pawel2000pl/LedDriverIoT/doc/example_board/IoT_Led_v1.kicad_pcb

## KiCad design doc/example_board/IoT_Led_v1.kicad_pcb (2026-05-27)

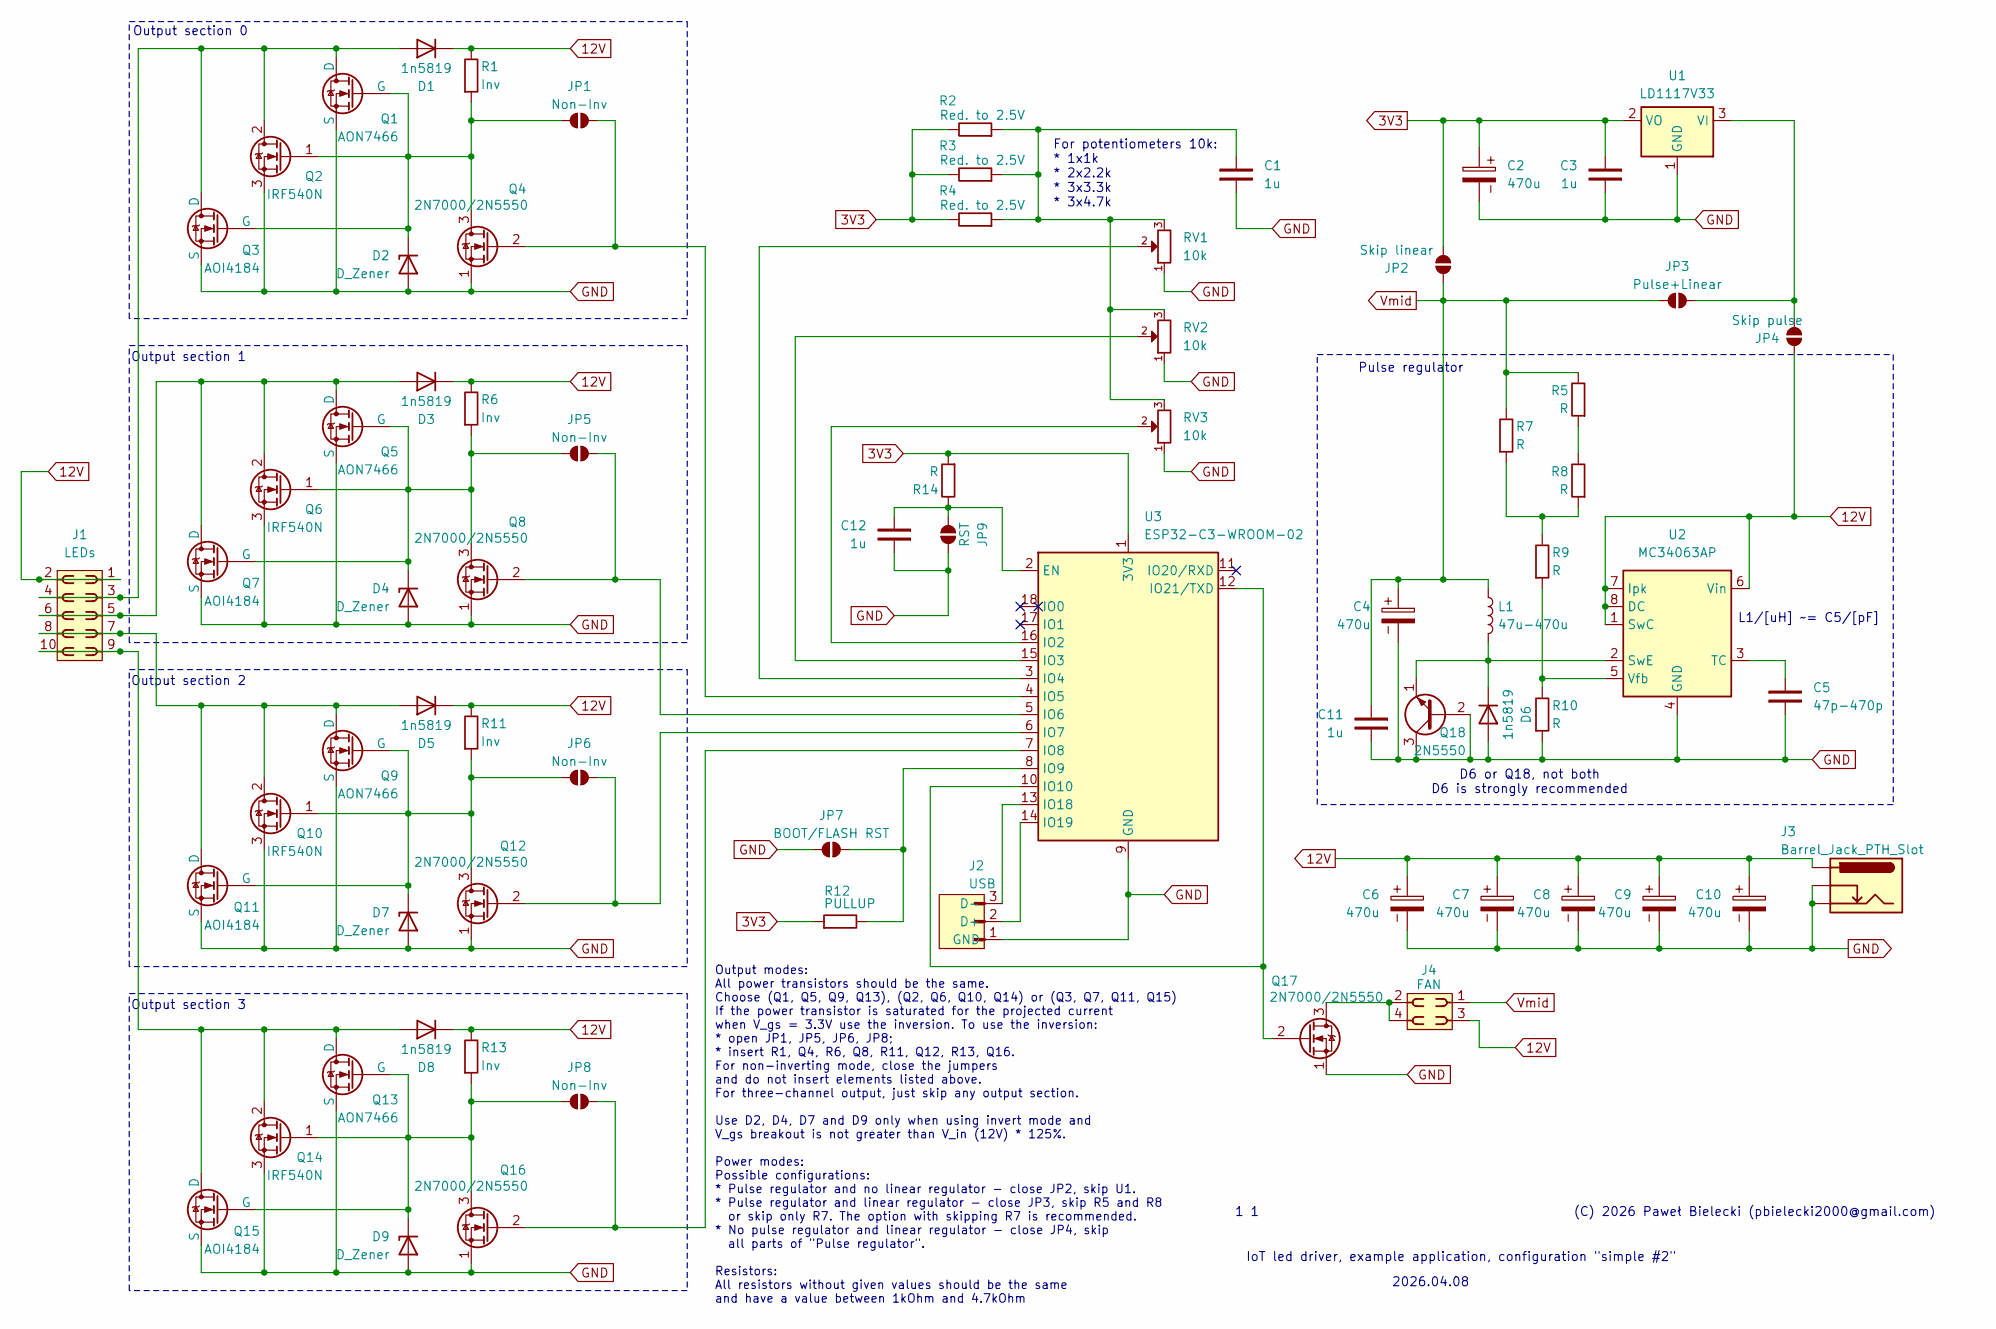
[picture p11: schematic IoT_Led_v1.kicad_sch]

Parts:
C1, C3, C11, C12: 1u; C_Disc_D3.0mm_W2.0mm_P2.50mm
C2, C4, C6, C7, C8, C9, C10: 470u; CP_Radial_D5.0mm_P2.50mm
C5: 47p-470p; C_Disc_D3.0mm_W2.0mm_P2.50mm
D1, D3, D5, D6, D8: 1n5819; D_DO-41_SOD81_P10.16mm_Horizontal
D2, D4, D7, D9: D_Zener; D_DO-41_SOD81_P10.16mm_Horizontal
J1: LEDs; PinSocket_2x05_P2.54mm_Vertical
J2: USB; PinHeader_1x03_P2.54mm_Vertical
J3: Barrel_Jack_PTH_Slot
J4: FAN; PinSocket_2x02_P2.54mm_Vertical
JP1, JP5, JP6, JP8: Non-Inv; Jumper_2_NO_NoSilk
JP2: Skip linear; Jumper_2_NO_NoSilk
JP3: Pulse+Linear; Jumper_2_NO_NoSilk
JP4: Skip pulse; Jumper_2_NO_NoSilk
JP7: BOOT/FLASH RST; Jumper_2_NO_NoSilk
JP9: RST; Jumper_2_NO_NoSilk
L1: 47u-470u; L_Axial_L5.3mm_D2.2mm_P2.54mm_Vertical_Vishay_IM-1
Q1, Q5, Q9, Q13: AON7466
Q2, Q6, Q10, Q14: IRF540N; TO-220-3_Vertical
Q3, Q7, Q11, Q15: AOI4184; TO-251-3_Vertical
Q4, Q8, Q12, Q16, Q17: 2N7000/2N5550; TO-92_Inline
Q18: 2N5550; TO-92_Inline
R1, R6, R11, R13: Inv; R_Axial_DIN0207_L6.3mm_D2.5mm_P10.16mm_Horizontal
R2, R3, R4: Red. to 2.5V; R_Axial_DIN0207_L6.3mm_D2.5mm_P10.16mm_Horizontal
R5, R7, R8, R9, R10, R14: R; R_Axial_DIN0207_L6.3mm_D2.5mm_P10.16mm_Horizontal
R12: PULLUP; R_Axial_DIN0207_L6.3mm_D2.5mm_P10.16mm_Horizontal
RV1, RV2, RV3: 10k; Potentiometer_Alps_RK163_Single_Horizontal
U1: LD1117V33; TO-220-3_Vertical
U2: MC34063AP; DIP-8_W7.62mm
U3: ESP32-C3-WROOM-02

Connections:
3V3: C2.1, C3.2, JP2.1 (A), R2.2, R3.2, R4.2, R12.1, R14.1, U1.2 (VO), U3.1 (3V3)
12V: C6.1, C7.1, C8.1, C9.1, C10.1, D1.1 (K), D3.1 (K), D5.1 (K), D8.1 (K), J1.1, J1.2, J3.PWR, J4.3, JP4.2 (B), R1.2, R6.2, R11.2, R13.2, U2.1 (SwC), U2.6 (Vin), U2.7 (Ipk), U2.8 (DC)
GND: C1.1, C2.2, C3.1, C4.2, C5.1, C6.2, C7.2, C8.2, C9.2, C10.2, C11.1, C12.1, D2.2 (A), D4.2 (A), D6.2 (A), D7.2 (A), D9.2 (A), J2.1 (GND), J3.GND, J3.GNDBREAK, JP7.1 (A), JP9.2 (B), Q1.3 (S), Q2.3 (S), Q3.3 (S), Q4.1 (S), Q5.3 (S), Q6.3 (S), Q7.3 (S), Q8.1 (S), Q9.3 (S), Q10.3 (S), Q11.3 (S), Q12.1 (S), Q13.3 (S), Q14.3 (S), Q15.3 (S), Q16.1 (S), Q17.1 (S), Q18.2 (B), Q18.3 (C), R10.1, RV1.1, RV2.1, RV3.1, U1.1 (GND), U2.4 (GND), U3.9 (GND), U3.19 (GND)
unnamed: C1.2, R2.1, R3.1, R4.1, RV1.3, RV2.3, RV3.3
unnamed: D1.2 (A), J1.3, J1.4, Q1.1 (D), Q2.2 (D), Q3.2 (D)
unnamed: D2.1 (K), JP1.2 (B), Q1.2 (G), Q2.1 (G), Q3.1 (G), Q4.3 (D), R1.1
unnamed: D3.2 (A), J1.5, J1.6, Q5.1 (D), Q6.2 (D), Q7.2 (D)
unnamed: D4.1 (K), JP5.2 (B), Q5.2 (G), Q6.1 (G), Q7.1 (G), Q8.3 (D), R6.1
unnamed: D5.2 (A), J1.7, J1.8, Q9.1 (D), Q10.2 (D), Q11.2 (D)
unnamed: D6.1 (K), L1.2, Q18.1 (E), U2.2 (SwE)
unnamed: D7.1 (K), JP6.2 (B), Q9.2 (G), Q10.1 (G), Q11.1 (G), Q12.3 (D), R11.1
unnamed: D8.2 (A), J1.9, J1.10, Q13.1 (D), Q14.2 (D), Q15.2 (D)
unnamed: D9.1 (K), JP8.2 (B), Q13.2 (G), Q14.1 (G), Q15.1 (G), Q16.3 (D), R13.1
unnamed: J2.2 (D+), U3.14 (IO19)
unnamed: J2.3 (D-), U3.13 (IO18)
unnamed: JP1.1 (A), Q4.2 (G), U3.4 (IO5)
unnamed: JP3.1 (A), JP4.1 (A), U1.3 (VI)
unnamed: JP5.1 (A), Q8.2 (G), U3.5 (IO6)
unnamed: JP6.1 (A), Q12.2 (G), U3.6 (IO7)
unnamed: JP7.2 (B), R12.2, U3.8 (IO9)
unnamed: JP8.1 (A), Q16.2 (G), U3.7 (IO8)
unnamed: C12.2, JP9.1 (A), R14.2, U3.2 (EN)
unnamed: J4.2, J4.4, Q17.3 (D)
unnamed: Q17.2 (G), U3.10 (IO10), U3.12 (IO21/TXD)
unnamed: R5.1, R8.2
unnamed: R7.1, R8.1, R9.2
unnamed: C5.2, U2.3 (TC)
unnamed: R9.1, R10.2, U2.5 (Vfb)
unnamed: RV3.2, U3.16 (IO2)
unnamed: RV2.2, U3.15 (IO3)
unnamed: RV1.2, U3.3 (IO4)
Vmid: C4.1, C11.2, J4.1, JP2.2 (B), JP3.2 (B), L1.1, R5.2, R7.2

Notes on the sheet:
L1/[uH] ~= C5/[pF]
2026.04.08
IoT led driver, example application, configuration "simple #2"
Output section 0
Pulse regulator
Output section 3
1 1
(C) 2026 Paweł Bielecki (pbielecki2000@gmail.com)
Output modes: All power transistors should be the same. Choose (Q1, Q5, Q9, Q13), (Q2, Q6, Q10, Q14) or (Q3, Q7, Q11, Q15) If the power transistor is saturated for the projected current when V_gs = 3.3V use the inversion. To use the inversion: * open JP1, JP5, JP6, JP8; * insert R1, Q4, R6, Q8, R11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
D6 or Q18, not both D6 is strongly recommended
For potentiometers 10k: * 1x1k * 2x2.2k * 3x3.3k * 3x4.7k
Output section 1
Output section 2

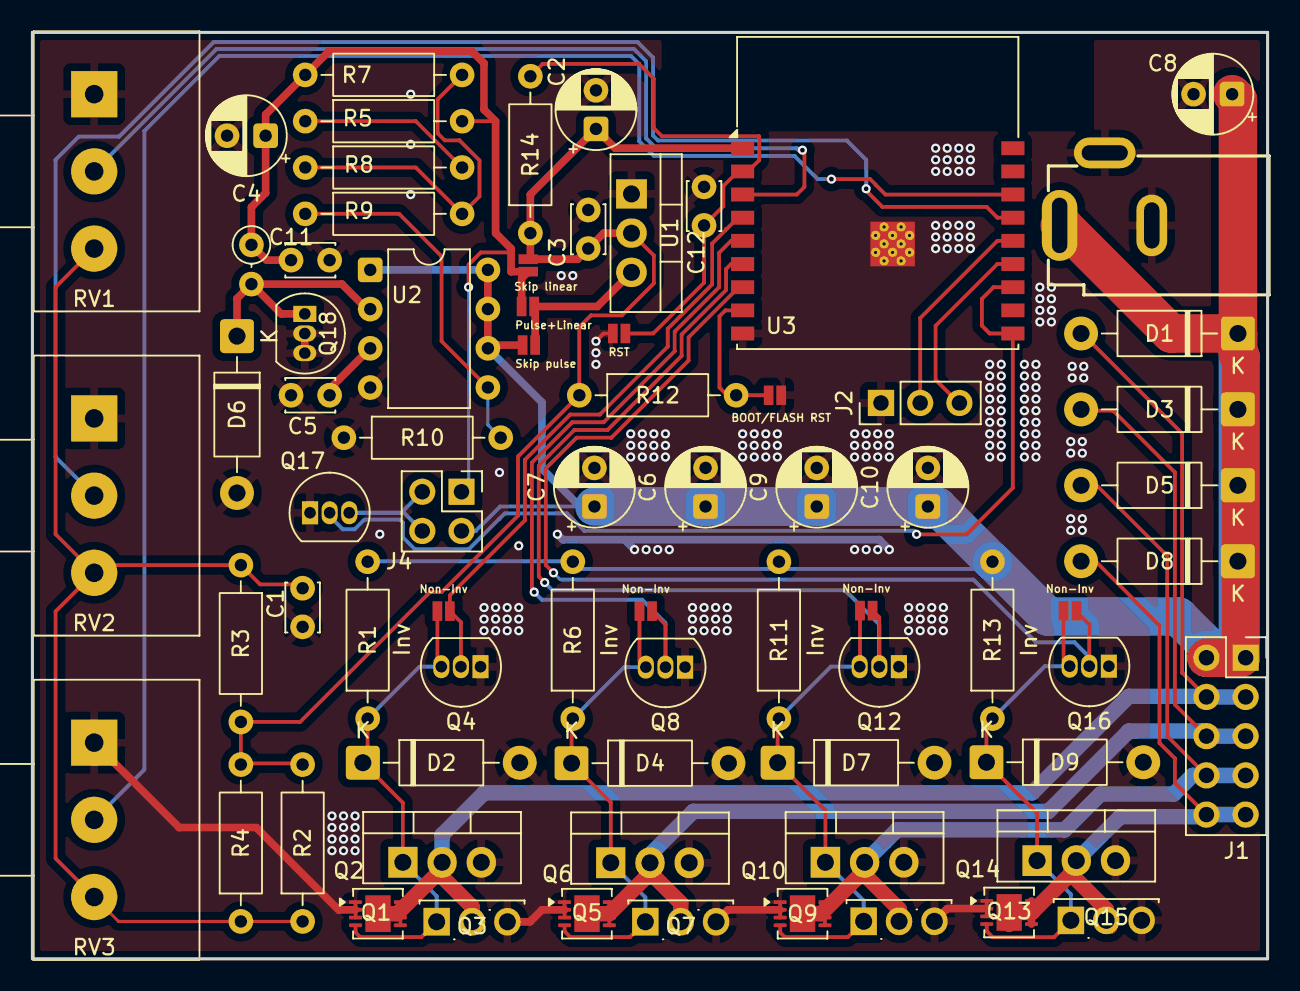
[picture p12: board IoT_Led_v1.kicad_pcb from above]

Board: 2 copper layers, 80.0 x 60.0 mm, 73 parts (0 on the bottom side), 32 nets.
