pawel2000pl/LedDriverIoT/main/src/hardware_configuration.cpp

#include "hardware_configuration.h"
#include "logs.h"
#include <cstdint>
#include <utility>

namespace hardware {


	void pullUpDelay() {
		delayMicroseconds(RELAXATION_PULL_DELAY);
	}


	void relaxationDelay() {
		auto wakeup = micros() + RELAXATION_DELAY;
		do vTaskDelay(5); while (micros() < wakeup);
	}


	std::pair<unsigned, unsigned> checkPin(int pin) {
		bool analogPin = pin >= 2 && pin <= 4;
		pinMode(pin, INPUT_PULLDOWN);
		pullUpDelay();
		unsigned v1 = analogPin ? analogRead(pin) : (ANALOG_READ_MAX * digitalRead(pin));
		pinMode(pin, INPUT_PULLUP);
		pullUpDelay();
		unsigned v2 = analogPin ? analogRead(pin) : (ANALOG_READ_MAX * digitalRead(pin));
		return {v1, v2};
	}


	// it just checks if a pin is not h/z
	bool analogHasPotentiometer(int pin) {
		auto v = checkPin(pin);
		return (v.first > ANALOG_READ_MAX * 0.1f) || (v.second < ANALOG_READ_MAX * 0.9f);
	}


	bool hasHz(int pin) {
		auto v = checkPin(pin);
		return (v.first < ANALOG_READ_MAX * 0.1f) && (v.second > ANALOG_READ_MAX * 0.9f);
	}


	bool hasLow(int pin) {
		auto v = checkPin(pin);
		return (v.first < ANALOG_READ_MAX * 0.1f) && (v.second < ANALOG_READ_MAX * 0.1f);
	}


	bool hasHigh(int pin) {
		auto v = checkPin(pin);
		return (v.first > ANALOG_READ_MAX * 0.9f) && (v.second > ANALOG_READ_MAX * 0.9f);
	}


	bool pinsAreConnected(int a, int b) {
		if (a == b) return true;

		pinMode(a, INPUT_PULLUP);
		pinMode(b, INPUT_PULLUP);
		pullUpDelay();
		bool v1a = digitalRead(a);
		bool v1b = digitalRead(b);

		pinMode(a, INPUT_PULLDOWN);
		pinMode(b, INPUT_PULLDOWN);
		pullUpDelay();
		bool v2a = !digitalRead(a);
		bool v2b = !digitalRead(b);

		bool result = false;

		if (v1a && v2a) { // if pin a has HZ
			pinMode(a, OUTPUT);
			digitalWrite(a, HIGH);
			pullUpDelay();
			result = digitalRead(b);
		} else if (v1b && v2b) { // if pin b has HZ
			pinMode(b, OUTPUT);
			digitalWrite(b, HIGH);
			pullUpDelay();
			result = digitalRead(a);
		} else {
			result = v1a == v1b && v2a == v2b && v1a == v2a;
		}

		pinMode(a, INPUT);
		pinMode(b, INPUT);

		return result;
	}


	fixed64 avgAnalog(int pin, unsigned count) {
		std::uint64_t sum = 0;
		for (unsigned i=0;i<count;i++)
			sum += analogRead(pin);
		return fixed64::fraction(sum, count);
	}


	fixed64 InputHardwareAction::read() const {
			if (!enabled) return 0;
			relaxationDelay();
			return avgAnalog(read_pin, 5) * fixed64::fraction(1, ANALOG_READ_MAX);
	}


	void InputHardwareAction::setInput() const {
		if (!enabled) return;
		pinMode(read_pin, INPUT);
		for (auto& pin : hz_pins)
			pinMode(pin, INPUT);
		for (auto& pin : high_pins) {
			pinMode(pin, OUTPUT);
			digitalWrite(pin, HIGH);
		}
		for (auto& pin : low_pins) {
			pinMode(pin, OUTPUT);
			digitalWrite(pin, LOW);
		}
		pinMode(read_pin, INPUT);
	}


	int InputHardwareAction::getPin(int disabledValue) const {
		return enabled ? read_pin : disabledValue;
	}


	bool InputHardwareAction::isAvailable() const {
		if (!enabled) return false;
		setInput();
		relaxationDelay();
		return analogHasPotentiometer(read_pin);
	}


	bool HardwareConfiguration::available() const {
		for (auto pin : requires_potentiometers)
			if (!analogHasPotentiometer(pin)) return false;
		for (auto pin : requires_hz)
			if (!hasHz(pin)) return false;
		for (auto pin : requires_lo)
			if (!hasLow(pin)) return false;
		for (auto pin : requires_hi)
			if (!hasHigh(pin)) return false;
		int shorted_size = requires_shorted.size();
		delay(5);
		for (int i=0;i<shorted_size;i++)
			pinMode(requires_shorted[i], INPUT);
		for (int i=0;i<shorted_size;i++)
			for (int j=i+1;j<shorted_size;j++)
				if (!pinsAreConnected(requires_shorted[i], requires_shorted[j]))
					return false;
		int not_shorted_size = requires_not_shorted.size();
		delay(5);
		for (int i=0;i<not_shorted_size;i++)
			pinMode(requires_not_shorted[i], INPUT);
		for (int i=0;i<not_shorted_size;i++)
			for (int j=i+1;j<not_shorted_size;j++)
				if (pinsAreConnected(requires_not_shorted[i], requires_not_shorted[j]))
					return false;
		return true;
	}

	void HardwareConfiguration::setup() {
		pinMode(fanPin, OUTPUT);
		pinMode(resetPin, INPUT_PULLUP);
		for (auto& inputAction: potentiometers)
			inputAction.enabled = inputAction.isAvailable();
		for (auto& inputAction: thermistors)
			inputAction.enabled = inputAction.isAvailable();
	}


	String HardwareConfiguration::getCode() const {
		char buffer[128] = {0};
		unsigned size = sprintf(buffer, "%s@f%02dr%02dp%02d%02d%02d%02dt%02d%02d%02d%02do%02d%02d%02d%02d",
			name, fanPin, resetPin,
			potentiometers[0].getPin(), potentiometers[1].getPin(), potentiometers[2].getPin(), potentiometers[3].getPin(),
			thermistors[0].getPin(), thermistors[1].getPin(), thermistors[2].getPin(), thermistors[3].getPin(),
			outputs[0], outputs[1], outputs[2], outputs[3]
		);
		buffer[size] = 0;
		return String(buffer);
	}


	HardwareConfiguration* configuration;

	void detectHardware() {
		analogReadResolution(12);

		unsigned size = std::end(configurations) - std::begin(configurations);

		int available = -1;

		for (int i=0;i<size;i++) {
			if (configurations[i]->available()) {
				if (available < 0) available = i;
				else {
					logs::logger.print("Error: detected at least two possible configurations: ");
					logs::logger.print(configurations[available]->name);
					logs::logger.print(" and ");
					logs::logger.println(configurations[i]->name);
				}
			}
		}

		if (available < 0) {
			available = 0;
			logs::logger.println("Cannot detect hardware properly");
		}

		logs::logger.print("Chosen configuration: ");
		logs::logger.println(configurations[available]->name);

		configuration = configurations[available];
		configuration->setup();
	}

}
