pawel2000pl/LedDriverIoT/main/src/ledc_driver.cpp

#include "ledc_driver.h"
#include <Arduino.h>
#include <driver/ledc.h>
#include "constrain.h"


namespace ledc {

	unsigned current_pwm_frequency = 32000;


	void init(void) {
		ledc_timer_config_t ledc_timer = {
			.speed_mode       = LEDC_MODE,
			.duty_resolution  = LEDC_DUTY_RES,
			.timer_num        = LEDC_TIMER,
			.freq_hz          = current_pwm_frequency,
			.clk_cfg          = LEDC_AUTO_CLK,
			#ifdef NEW_FLAGS
			.deconfigure	  = false
			#endif
		};
		// screw errors, it works fine
		ledc_timer_config(&ledc_timer);
	}


	void checkNewFrequency(unsigned freq) {
		if (freq >= 1000 && freq <= 32000 && freq != current_pwm_frequency) {
			current_pwm_frequency = freq;
			ledc_set_freq(LEDC_MODE, LEDC_TIMER, current_pwm_frequency);
		}
	}


	fixed64 addGateLoadingTime(fixed64 value, fixed64 loadingTime) {
			if (value == 0) return 0;
			constexpr static const fixed64 k = fixed64::fraction(1, 1000000);
			fixed64 offset = loadingTime * current_pwm_frequency * k;
			return value / (1 - offset) + offset;
	}


	struct ChannelCache {
			bool initialized = false;
			uint32_t duty = 0;
			int hpoint = 0;
			bool invert = false;
	};

	ChannelCache cache[4];

	void setChannel(int gpio, unsigned channel, fixed64 value, fixed64 phase, bool invert) {
		uint32_t duty = (uint32_t)constrain<int>(std::round(value * (LEDC_PERIOD-1)), 0, LEDC_PERIOD-1);
		int hpoint = constrain<int>(std::round(phase * (LEDC_PERIOD-1)), 0, LEDC_PERIOD-1);
		if (cache[channel].initialized && cache[channel].duty == duty && cache[channel].hpoint == hpoint && cache[channel].invert == invert)
			return;
		cache[channel].hpoint = hpoint;
		cache[channel].duty = duty;
		cache[channel].invert = invert;
		cache[channel].initialized = true;
		ledc_channel_config_t ledc_channel = {
			.gpio_num       = gpio,
			.speed_mode     = LEDC_MODE,
			.channel        = (ledc_channel_t)channel,
			.intr_type      = LEDC_INTR_DISABLE,
			.timer_sel      = LEDC_TIMER,
			.duty           = duty,
			.hpoint         = hpoint,
			#ifdef NEW_FLAGS
			.sleep_mode		= LEDC_SLEEP_MODE_KEEP_ALIVE,
			#endif
			.flags          = { .output_invert = (invert ? 1u : 0u) }
		};
		ledc_channel_config(&ledc_channel);
	}

}
