pawel2000pl/LedDriverIoT/main/src/hardware_configuration.h

#pragma once

#include <Arduino.h>
#include <array>

#include "lib/ArduinoJson/ArduinoJson.h"

#include "inplace_vector.h"
#include "common_types.h"
#include "json_utils.h"

#define ANALOG_READ_MAX 4095
#define RELAXATION_DELAY 30
#define RELAXATION_PULL_DELAY 5000

namespace hardware {

	struct InputHardwareAction {
		bool enabled = false;
		char read_pin;
		inplace_vector<char, 4> hz_pins;
		inplace_vector<char, 4> low_pins;
		inplace_vector<char, 4> high_pins;
		fixed64 read() const;

		bool isAvailable() const;
		int getPin(int disabledValue=0) const;
		void setInput() const;
	};


	struct HardwareConfiguration {
		const char* name;
		char fanPin;
		char resetPin;
		std::array<InputHardwareAction, 4> potentiometers;
		std::array<InputHardwareAction, 4> thermistors;
		std::array<char, 4> outputs;

		inplace_vector<char, 24> requires_potentiometers = {};
		inplace_vector<char, 24> requires_hz = {};
		inplace_vector<char, 24> requires_lo = {};
		inplace_vector<char, 24> requires_hi = {};
		inplace_vector<char, 24> requires_shorted = {};
		inplace_vector<char, 24> requires_not_shorted = {};

		bool available() const;
		void setup();
		String getCode() const;
	};

	void detectHardware();

	extern inplace_vector<HardwareConfiguration*, 16> configurations;
	extern HardwareConfiguration* configuration;

}
