pawel2000pl/LedDriverIoT/main/src/animations.cpp

#include <Arduino.h>
#include <cstdint>
#include <array>
#include <esp_random.h>

#include "constrain.h"
#include "animations.h"
#include "inputs.h"
#include "outputs.h"
#include "knobs.h"
#include "configuration.h"
#include "timer_shutdown.h"

namespace animations {

    constexpr const unsigned max_stages = 16;
    constexpr const unsigned max_next_stage = 16;

    struct AnimationStage;

    using StagesArray = std::array<AnimationStage, max_stages>;

    struct AnimationTransition {
        long int start_ms;
        long int end_ms;
        long int next_ms;
        ColorChannels start_color;
        ColorChannels end_color;
        const AnimationStage* next_stage;
        void setColor();
    };

    struct AnimationStage {
        unsigned fade_in_ms;
        unsigned fade_in_randomness;
        unsigned period_ms;
        unsigned period_randomness;
        ColorChannels base_color;
        ColorChannels color_randomness;
        std::array<std::int8_t, max_next_stage> next_stages;
        std::uint8_t next_stages_size;
        bool use_white;
        void generateTransition(AnimationTransition* transition) const;
    };


    bool animation_enabled = false;
    StagesArray loaded_stages;
    AnimationTransition current_transition;


    void checkTimer() {
        if (animation_enabled) {
            current_transition.setColor();
        }
    }


    bool startAnimation(unsigned id, bool checkMinimum) {
        JsonDocument animations = configuration::getAnimations();
        unsigned size = animations.size();
        if (id >= size) return false;
        startAnimationFromJson(animations[id], checkMinimum);
        return true;
    }


    void startAnimationFromJson(const JsonVariantConst animationSequence, bool checkMinimum) {
        const JsonVariantConst stages = animationSequence["data"];
        unsigned stages_count = stages.size();
        if (stages_count > max_stages) stages_count = max_stages;
        if (!stages_count) return;
        for (unsigned i=0;i<stages_count;i++) {
            AnimationStage& stage = loaded_stages[i];
            const JsonVariantConst stage_json = stages[i];
            stage.fade_in_ms = stage_json["fade_in_ms"].as<unsigned>();
            stage.fade_in_randomness = stage_json["fade_in_randomness"].as<unsigned>();
            stage.period_ms = stage_json["period_ms"].as<unsigned>();
            stage.period_randomness = stage_json["period_randomness"].as<unsigned>();
            const auto base_color = stage_json["base_color"];
            for (unsigned j=0;j<4;j++)
                stage.base_color[j] = base_color[j].as<fixed32_c>();
            const auto color_randomness = stage_json["color_randomness"];
            for (unsigned j=0;j<4;j++)
                stage.color_randomness[j] = color_randomness[j].as<fixed32_c>();
            const auto next_stages = stage_json["next_stages"];
            stage.next_stages_size = next_stages.size();
            if (stage.next_stages_size > max_next_stage) stage.next_stages_size = max_next_stage;
            for (unsigned j=0;j<stage.next_stages_size;j++) {
                unsigned val = next_stages[j].as<unsigned>();
                if (val >= stages_count) val %= stages_count;
                stage.next_stages[j] = val;
            }
            stage.use_white = stage_json["use_white"].as<bool>();
        }
        fixed32_c hue_zero;
        hue_zero = loaded_stages[0].base_color[0];
        for (int i=0;i<max_stages;i++)
            loaded_stages[i].base_color[0] = (loaded_stages[i].base_color[0] - hue_zero).fmod1();
        ColorChannels current_color = outputs::getColor();
        current_color[0] = hue_zero;
        current_color[1] = 1;
        if (checkMinimum && !current_color[2]) current_color[2] = 0.1;
        if (checkMinimum && !current_color[3]) current_color[3] = 0.1;
        outputs::makeDistortion(current_color);
        inputs::source_control = inputs::scWeb;
        timer_shutdown::resetTimer();
        loaded_stages[0].generateTransition(&current_transition);
        animation_enabled = true;
    }


    void stopAnimation() {
        outputs::applyCurrentDistortion();
        outputs::writeOutput();
        animation_enabled = false;
        inputs::source_control = inputs::scWeb;
        timer_shutdown::resetTimer();
    }


    void AnimationTransition::setColor() {
        ColorChannels out_color;
        unsigned long current_time = millis();
        if (current_time >= end_ms) {
            out_color = end_color;
        } else {
            fixed32_c frac = fixed32_c::fraction(current_time - start_ms, end_ms - start_ms);
            fixed32_c rest = 1 - frac;
            for (int i=0;i<4;i++)
                out_color[i] = start_color[i] * rest + end_color[i] * frac;
        }
        outputs::setDistortion(out_color);
        outputs::writeOutput();
        if (current_time >= next_ms)
            next_stage->generateTransition(this);
    }


    void AnimationStage::generateTransition(AnimationTransition* transition) const {
        transition->start_ms = millis();
        transition->end_ms = transition->start_ms + fade_in_ms;
        if (fade_in_randomness)
            transition->end_ms += esp_random() % (fade_in_randomness + 1);
        transition->next_ms = transition->end_ms + period_ms;
        if (period_randomness)
            transition->next_ms += esp_random() % (period_randomness + 1);
        transition->start_color = outputs::getDistortion();
        ColorChannels color;
        for (int i=0;i<4;i++) {
            color[i] = base_color[i];
            if (color_randomness[i] > 0) {
                color[i] += fixed32_c::buf_cast(esp_random() % (color_randomness[i].getBuf()+1)) - (color_randomness[i] >> 1);
                if (i) color[i] = constrain<fixed32_c>(color[i], 0, 1);
            }
        }
        if (!use_white) color[3] = 1;
        transition->end_color = color;
        transition->start_color[0] = transition->start_color[0].fmod1();
        transition->end_color[0] = transition->end_color[0].fmod1();
        // hue fixes - shorter path
        if (transition->end_color[0] - transition->start_color[0] > fixed32_c::fraction(1, 2))
            transition->start_color[0] += 1;
        else if (transition->start_color[0] - transition->end_color[0] > fixed32_c::fraction(1, 2))
            transition->end_color[0] += 1;
        transition->next_stage = this;
        if (next_stages_size)
            transition->next_stage = &loaded_stages[next_stages[esp_random() % next_stages_size]];
    }


}
