pawel2000pl/LedDriverIoT/main/src/dynamic_buffers.h

#pragma once

#include <Arduino.h>
#include "lib/esp32_https_server/HTTPRequest.hpp"
#include "lib/esp32_https_server/HTTPResponse.hpp"

using HTTPResponse = httpsserver::HTTPResponse;
using HTTPRequest = httpsserver::HTTPRequest;

namespace server {

    class RequestReader {
    public:
        RequestReader(HTTPRequest* req);

        int read();
        size_t readBytes(char* buffer, size_t length);

    private:
        static const int bufferSize = 512;

        HTTPRequest* request;
        int bufPos;
        int bufSize;
        bool bufEnded;
        unsigned char buffer[bufferSize];

        void readBuffer();
    };


    class ResponseWriter : public Print {
        public:
            ResponseWriter(HTTPResponse* res);
            ~ResponseWriter();

            size_t write(uint8_t c);
            size_t write(const uint8_t *buffer, size_t length);
        private:
            static const int bufferSize = 512;

            HTTPResponse* response;
            int bufPos;
            unsigned char buffer[bufferSize];

            void writeBuffer();
    };

}
