pawel2000pl/LedDriverIoT/main/src/inputs.h

#pragma once
#include <Arduino.h>
#include "lib/ArduinoJson/ArduinoJson.h"

#include "common_types.h"
#include "json_utils.h"
#include "filter_functions.h"


namespace inputs {

    enum SourceControl {scNone, scKnobs, scWeb, scFadingOut};
    extern SourceControl source_control;

    void updateConfiguration(const JsonVariantConst configuration);
    void setRGBW(fixed32_c r, fixed32_c g, fixed32_c b, fixed32_c w);
    void setHSVW(fixed32_c h, fixed32_c s, fixed32_c v, fixed32_c w);
    void setHSLW(fixed32_c h, fixed32_c s, fixed32_c l, fixed32_c w);
    void setAuto(const String& colorspace, const ColorChannels& color);

    ColorChannels prepareRGBW(fixed32_c r, fixed32_c g, fixed32_c b, fixed32_c w);
    ColorChannels prepareHSVW(fixed32_c h, fixed32_c s, fixed32_c v, fixed32_c w);
    ColorChannels prepareHSLW(fixed32_c h, fixed32_c s, fixed32_c l, fixed32_c w);
    ColorChannels prepareAuto(const String& colorspace, const ColorChannels& color);

    ColorChannels getRGBW();
    ColorChannels getHSVW();
    ColorChannels getHSLW();
    ColorChannels getAuto(const String& colorspace);

    String dumpFavoriteColor(const bool useWhite);
    ColorChannels decodeFavoriteColor(const String& formattedColor, bool* useWhitePtr);
    ColorChannels favoriteColorPreview(const String& colorspace, const String& formattedColor);
    void applyFavoriteColor(const String& formattedColor);

    namespace filters {
        extern MixedFunction inputSaturation;
        extern MixedFunction inputHueBasic;
        extern MixedFunction inputValue;
        extern MixedFunction inputLightness;
        extern MixedFunction inputRed;
        extern MixedFunction inputGreen;
        extern MixedFunction inputBlue;
        extern MixedFunction inputWhite;
        extern MixedFunction globalInput;

        fixed64_f inputHue(fixed64_f x);
        fixed64_f invertedInputHue(fixed64_f y);
        fixed64_f invertedInputSaturation(fixed64_f y);
        fixed64_f invertedInputValue(fixed64_f y);
        fixed64_f invertedInputLightness(fixed64_f y);
        fixed64_f invertedInputRed(fixed64_f y);
        fixed64_f invertedInputGreen(fixed64_f y);
        fixed64_f invertedInputBlue(fixed64_f y);
        fixed64_f invertedInputWhite(fixed64_f y);
        fixed64_f invertedGlobalInput(fixed64_f y);
    }

}
