pawel2000pl/LedDriverIoT/main/src/validate_json.h

#pragma once
#include "lib/ArduinoJson/ArduinoJson.h"

#ifndef ARDUINO
  using String = std::string;
#endif

extern JsonDocument JsonEmpty;
extern JsonDocument JsonNull;

String validateJson(JsonVariant object, const JsonVariantConst schema, const JsonVariantConst objectType, String path=".", const JsonVariantConst defaults=JsonNull);
