pawel2000pl/LedDriverIoT/main/src/temperature.h

#pragma once

#include <array>

#include "common_types.h"

#define RESTART_TEMP 85
#define ALLOW_ON_MAX_TEMP 75
#define ALLOW_ON_MIN_TEMP -30
#define FAN_TURN_ON_TEMP 70
#define FAN_TURN_OFF_TEMP 45
#define THERMISTOR_CONST 4050.0f
#define THERMISTOR_R0 47000
#define THERMISTOR_IN_SERIES_RESISTOR 47000
#define THERMISTOR_T0 (25.0f + 273.15f)


namespace temperature {

    struct TemperatureResults {
        float internal = 0;
        std::array<float, 4> external = {0, 0, 0, 0};
        float max();
        bool tooHot();
    };

    void init();
    TemperatureResults check();
    TemperatureResults readTemperatures();
    void block_until_is_ok();

}
