pawel2000pl/LedDriverIoT/main/functions.cpp

#include <math.h>
#include <functional>
#include <array>
#include "json.h"
#include "functions.h"

FloatFunction normalizeFunction(FloatFunction fun, float min_x, float max_x) {
  const float fmin = fun(min_x);
  const float fmax = fun(max_x);
  const float x_diff = max_x-min_x;
  const float minff = min(fmin, fmax);
  const float absfdiff = abs(fmax-fmin);
  return [=](float x) { return (fun(x*x_diff+min_x)-minff) / absfdiff; };
}

FloatFunction constrainFunction(FloatFunction fun, float min_y, float max_y) {
  return [=](float x) {
    float y = fun(x);
    return (y < min_y) ? min_y : (y > max_y) ? max_y : y;
  };
}

FloatFunction symFunction(FloatFunction fun) {
  return [=](float x) { return 1-fun(1-x); };
}

FloatFunction filterFunctions[] = {
  [](float x) {return x; },
  [](float x) {return x*x; },
  [](float x) {return sqrt(x); },
  normalizeFunction([](float x) { return exp(M_PI*(x-1)); }),
  normalizeFunction([](float x) { return asin(x*2-1); }),
  normalizeFunction([](float x) { return cos((x - 1) * M_PI); }),
  symFunction([](float x) {return x*x; }),
  symFunction([](float x) {return sqrt(x); }),
  normalizeFunction(symFunction([](float x) { return exp(M_PI*(x-1)); }))
};

FloatFunction mixFilterFunctions(const JsonArrayConst& filters) {
  std::array<float, 9> values;
  for (int i=0;i<9;i++)
    values[i] = filters[i].as<float>();
  return constrainFunction(normalizeFunction([=](float x) { 
    float sum = 0;
    for (int i=0;i<9;i++)
      if (values[i] != 0)
        sum += values[i] * filterFunctions[i](x);
    return sum;
  }));
}

FloatFunction createInverseFunction(FloatFunction originalFunction) {
    const bool minus = originalFunction(0) > originalFunction(1);    
    return [=](float y) {
        float left = 0;
        float right = 1;
        const float epsilon = 1e-6;
        if (minus) y = -y;
        while (right - left > epsilon) {
            const float mid = (left + right) / 2;
            float value = originalFunction(mid);
            if (minus) value = -value;
            if (value < y)
              left = mid;
            else
              right = mid;
        }
        return left; 
    };
}
