pawel2000pl/LedDriverIoT/(commit log)

2024-05-07 Added input function filtering to WiFi
2024-05-08 Fixed filters (added bidirectional filtering)
2024-05-08 Added functions for filtering outputs
2024-05-09 Moved input filtering to server
2024-05-11 Added outputs. Added reading analog inputs. Added pin (button) for resetting configuration.
    [ledc_driver.h]
2024-05-12 Added output inversion. Added temperature measurment and fan control
2024-05-15 Interfrating with idf
    [partitions.csv]
2024-05-15 partitions update
    [partitions.csv]
2024-05-25 Added full support for multiplexer
    [configuration.h]
2024-05-25 Added hardware detection (for one software for all types)
    [configuration.h]
2024-05-25 Bug fixes after test of knobs (multiplexer or not etc)
    [configuration.h]
2024-05-25 Added ground to thermistors
2024-05-26 Added knobs noises reduction to user configuration
    [configuration.cpp]
2024-05-27 Fixed flickering at 330Hz. Added delay for gate charging to minimal value.
    [ledc_driver.cpp, ledc_driver.h]
2024-10-01 Repaired bias configuration. Fixed example application: max analog voltage is 2.5V. Added default "favorite" colors.
2024-10-04 Huge code refactorization. Improvment: when color is changed to black, hue and saturation does not reset.
    [conversions.cpp, conversions.h, filter_functions.cpp]
2024-10-04 Readme update Filters gui update
2024-10-08 Added scalling to output channels to tailor led strips for true colors.
2024-10-10 Phases refactorization. Fixed error with white channel in eco mode.
    [knobs.cpp]
2024-10-10 Refactorization. Fixed problems with saturation on RGB mode. Added statisticts to compilation script
    [inputs.cpp, inputs.h, knobs.cpp, outputs.cpp, outputs.h]
2024-10-12 Fixed error with disconnectiong AP on confg page.
    [wifi.cpp]
2024-10-12 Added knob checking with timer. Added random cache max-age.
2024-10-18 Added middle-click event to menu buttons. Changed knob (read) frequency to 60Hz.
2024-10-20 Fixed problems with hidden wifi. Fixed problems with new menu buttons navigation.
    [wifi.cpp]
2024-10-20 Added compability with ESP32-C3-Zero (Waveshare)
2024-10-21 Fixed compability with esp32c3-zero
    [hardware_configuration.cpp, hardware_configuration.h, knobs.cpp, outputs.cpp]
2024-10-21 Updated documentation
    [pinout-usage.ods]
2024-10-21 Removed columns from documentation. Updated gitignore & dockerignore
    [pinout-usage.ods]
2024-10-21 Removed controllin onboard led on Waveshare esp32c3-zero
2024-10-24 Refactorization of configuration
    [configuration.h]
2024-11-03 Files reorganization 1
    [configuration.h]
2024-11-03 Files reorganization 2
    [configuration.h]
2024-11-03 Storing certificates in SPIFFS
    [configuration.h]
2024-11-04 Storing certs
    [configuration.h]
2024-11-06 Added additional actions like removing cert, restart or running connection pipeline
    [configuration.h]
2024-11-09 Added temperature endpoint
2024-12-18 Settings channel limits from current set
2024-12-29 Fixes for ArduinoJson v7 Added logs
    [configuration.h]
2024-12-30 Fixed testing for string in json validator
    [validate_json.cpp]
2024-12-30 Loading file content to dynamic vector. Fixed build script
    [configuration.h]
2025-01-01 Fixed json validation. Added tests for configuration.
    [validate_json.cpp]
2025-01-01 Added enabling colors. Fixed "enble" misspell. Fixed upgrading client app.
    [modules.cpp, modules.h]
2025-01-03 Fixed flickering when turning off leds channel.
    [ledc_driver.cpp, outputs.cpp]
2025-04-29 Added fixed point arithmetic
    [configuration.h]
2025-05-02 Unified converter of fixedpoint to arduino json
    [json_utils.h]
2025-05-02 Decreased size of using fixedpoint
    [common_types.h, conversions.cpp, conversions.h, filter_functions.cpp, filter_functions.h, hardware_configuration.cpp, hardware_configuration.h]
2025-05-02 Replaced fraction32 with fixed32
    [common_types.h, conversions.cpp, conversions.h, filter_functions.cpp, filter_functions.h, hardware_configuration.cpp, hardware_configuration.h]
2025-05-02 Fixed changes. Works almost good.
    [conversions.cpp, filter_functions.cpp, outputs.cpp]
2025-05-03 Increased resolution to fixed64
    [common_types.h, conversions.cpp, conversions.h, filter_functions.cpp, filter_functions.h, hardware_configuration.cpp]
2025-05-04 Changed names from "float" to "fixed". Updated endpoints to works with fixedpoints
    [inputs.cpp, outputs.cpp, outputs.h]
2025-05-06 Fixed errors in calculations on c++20<
    [knobs.cpp]
2025-10-04 Fixed overwriting settings if saved before loaded. Added multiple trials for mounting SPIFFS. Added rewriting filesystem in case of error.
    [configuration.cpp, conversions.cpp]
2025-10-05 Fixed fixedpoint and conversions
    [conversions.cpp]
2025-10-05 Fixed reading knobs. Added shutdown timeout.
    [hardware_configuration.cpp, inputs.h, knobs.cpp, knobs.h]
2025-10-06 Moved fading out to "output" module. Added simple lock for timer. Added additional information for printing by compile_resources.py script.
2025-11-14 Added configuration specialized for boards
    [pinout-usage.ods]
2025-11-18 Downloaded ArduinoJson and esp32_https_server
    [configuration.h]
2025-11-18 Updated idf-build (to master)
    [configuration.h, pinout-usage.ods]
2025-11-19 Made it compile and work
    [partitions.csv]
2025-11-29 Optimalization. Fixed problem with overloading of filters.
    [common_types.h, conversions.cpp, filter_functions.cpp, filter_functions.h, inputs.cpp, inputs.h, outputs.cpp]
2025-11-29 Created module for animations. Changed random source to true ranom generator.
    [configuration.h]
2025-11-30 Added endpoints for animations
    [configuration.h]
2025-12-01 Unified menu. Marked passwords for wifi as text to avoid saving in browser. Added font for password inputs.
    [configuration.cpp]
2025-12-06 Changed inputs in animation frontend. Added sample colors on stage header
2025-12-12 Added saving and loading stages
2025-12-15 Added savings and loading for stages. Oprimized json serialization.
    [configuration.h]
2025-12-17 Modified usage of ArduinoJson (removed references for JsonVariant). Refactored functions for loading and saving jsons on frontend. Added utils functions for animations.
2026-03-28 Fixed aniations wwhen any randomness time is zero
    [animations.cpp]
2026-03-28 Fixed problems with sending (large) resources through https
    [server.cpp]
2026-03-29 Memory optimalization
    [configuration.h]
2026-03-29 Fixed error with global animation lightness when no randomness
    [animations.cpp]
2026-03-30 Changed animations fps to 120. Minor frontend fixes
    [threads_mgr.cpp]
2026-04-01 Using floats when calculating approximation of filters. Removed taylormath. Fixed changing white channel on animations. Updated source control. Updated statistics in Readme. Added namespace for ledc
    [animations.cpp, common_types.h, default_color.cpp, filter_functions.cpp, filter_functions.h, inputs.cpp, inputs.h, knobs.cpp]
2026-04-02 Enchanced knobs amortisation. Changed name of fixed32_f to fixed64_f
    [common_types.h, filter_functions.cpp, filter_functions.h, hardware_configuration.cpp, hardware_configuration.h, inputs.cpp, inputs.h, knobs.cpp]
2026-04-04 Added class nd endpoint for 1kB of logs. Added flags for servers state. Fixed WiFi behaviour after disconnecting AP when built with idf. Added flag for checking if there was any query (instead of tim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
    [configuration.cpp, logs.cpp, logs.h, main.cpp, modules.cpp]
2026-04-06 Fixed inplace vector. Updated sdkconfig.
    [inplace_vector.h]
2026-04-07 Pretty sure that now it's fixed
    [hardware_configuration.cpp, hardware_configuration.h, inplace_vector.h, main.cpp, modules.cpp]
2026-04-07 Simplify functions for checking pin connections
2026-04-08 Added example KiCad project
    [IoT_Led_v1.kicad_pcb, IoT_Led_v1.kicad_sch]
2026-04-08 Updated readme, added cheatsheet for esp32c3-vroom-v2
2026-04-08 Added checking availability of components. Added resistors description on KiCad sch.
    [IoT_Led_v1.kicad_sch]
2026-04-09 Upgrading the example board
    [IoT_Led_v1.kicad_pcb, IoT_Led_v1.kicad_sch]
2026-04-11 Updated default filters
2026-04-11 Removed unused libraries from Arduino Docker container
2026-04-14 Added checking if the file was saved
    [configuration.h]
2026-04-19 Fixed detecting the hardware configuration. Removed rewritting the configuration on every startup.
    [configuration.h]
2026-04-20 Added moving buttons for moving animations (up/down)
2026-04-20 Board upgrade
    [IoT_Led_v1.kicad_pcb, IoT_Led_v1.kicad_sch]
2026-04-20 Fixed buttons up&down in animations.
2026-04-24 Fixes: removed rests of animation lightness, added values normalization in some places. Optimized hue-zero functionality.
    [animations.cpp, default_color.cpp, outputs.cpp]
2026-04-25 Board update
    [IoT_Led_v1.kicad_pcb, IoT_Led_v1.kicad_sch]
2026-04-27 Fixed default animations settings. Fixed default black animation.
    [animations.cpp, animations.h, default_color.cpp]
2026-04-28 Board update - added a capacitor and a resistor for CHP_EN, added a rst pad
    [IoT_Led_v1.kicad_pcb, IoT_Led_v1.kicad_sch]
